I-Grebot/holoboard/elec/bom/holoboard.xlsx

Sheet: Part List Report
 | Component list |  |  | <Parameter Title not found>
 | Source Data From: |  |  | holoboard.PrjPCB
 | Project: |  |  | holoboard.PrjPCB
 | Variant: |  |  | None
 | Report Date: |  | 06/02/2017 | 20:34:35
 | Print Date: |  | 2017-02-07 | 18:57:03
# | Designator | Footprint | Designator | LibRef | Value | Footprint | Part number | Quantity
1 | C1, C6 | C0603 | C1, C6 | Cap | 18pF | C0603 | 1759056 | 2
2 | C2, C4, C5, C7, C8, C9, C13, C22, C23, C32, C33, C34, C35 | C0603 | C2, C4, C5, C7, C8, C9, C13, C22, C23, C32, C33, C34, C35 | Cap | 10nF | C0603 | 1759102 | 13
3 | C3, C11, C16, C17, C18, C20, C21, C28, C29, C30, C31, C36, C37, C38 | C0603 | C3, C11, C16, C17, C18, C20, C21, C28, C29, C30, C31, C36, C37, C38 | Cap | 100nF | C0603 | 9406140 | 14
4 | C10, C12 | Boitier tantale A | C10, C12 | Cap Pol | 2.2µF | Boitier tantale A | 1457419 | 2
5 | C14 | C0805 | C14 | Cap | 10µF | C0805 | 2320851 | 1
6 | C15 | C0603 | C15 | Cap | 1µF | C0603 | 2320814 | 1
7 | C19 | Boitier tantale A | C19 | Cap Pol | 1.5µF | Boitier tantale A | 2408591 | 1
8 | C24, C25, C26, C27 | Boitier tantale B | C24, C25, C26, C27 | Cap Pol | 22µF | Boitier tantale B | 1135057 | 4
9 | C39, C51, C52 | Boitier tantale B | C39, C51, C52 | Cap | 22µF | Boitier tantale B | 2353055 | 3
10 | C40, C41, C42, C43, C44, C45 | Boitier tantale B | C40, C41, C42, C43, C44, C45 | Cap Pol | 10µF | Boitier tantale B | 1457437 | 6
11 | C46, C53, C54 | Boitier tantale C | C46, C53, C54 | Cap Pol | 100µF | Boitier tantale D | 1135058 | 3
12 | C47, C48, C49, C50, C55, C56 | C0805 | C47, C48, C49, C50, C55, C56 | Cap | 2,2µF | C0805 | 2320829 | 6
13 | D1 | WL-SFTW SMD | D1 | CLV1A-FKB |  | WL-SFTW SMD | 1855553 | 1
14 | D2, D3, D4, D5, D6, D7 | KP-2012 | D2, D3, D4, D5, D6, D7 | LED1 |  | KP-2012 |  | 6
15 | L1 | 0805 | L1 | Inductor | 600 @ 100MHz | 0805 |  | 1
16 | P1 | HDR1X6 | P1 | Header 6 |  | HDR1X6 |  | 1
17 | P2, P4 | 22-03-5035 | P2, P4 | Header 3 |  | 22-03-5035 |  | 2
18 | P3 | minitek127-6way | P3 | Header 6 |  | minitek127-6way |  | 1
19 | P5, P8 | 22-03-5045 | P5, P8 | Header 4 |  | 22-03-5045 |  | 2
20 | P6, P7 | 53253-0370 | P6, P7 | Header 3 |  | 53253-0370 |  | 2
21 | P9, P10, P11, P12 | 114-15030 | P9, P10, P11, P12 | Header 4X2 |  | 114-15030 |  | 4
22 | P13, P14, P15, P16, P17, P19, P20, P21, P22, P23, P24, P25, P26, P27, P28, P29, P30, P31 | 7-215079-4 | P13, P14, P15, P16, P17, P19, P20, P21, P22, P23, P24, P25, P26, P27, P28, P29, P30, P31 | Header 4 |  | 7-215079-4 |  | 18
23 | P18 | HDR2X8 | P18 | Header 2X8 |  | HDR2X8 |  | 1
24 | P32, P33, P34, P35, P36, P37, P38, P39 | HDR1X3 | P32, P33, P34, P35, P36, P37, P38, P39 | Header 3 |  | HDR1X3 |  | 8
25 | P40 | HDR1X4 | P40 | Header 4 |  | HDR1X4 |  | 1
26 | P41 | IMO - 20.155MH/4 | P41 | Header 4 |  | IMO - 20.155MH/4 |  | 1
27 | P42 | IMO - 20.155MH/2 | P42 | Header 2 |  | IMO - 20.155MH/2 |  | 1
28 | Q1, Q2, Q3 | SOT-23 | Q1, Q2, Q3 | NMOS-2 |  | SOT-23 |  | 3
29 | R1, R51, R53, R54 | 0603 | R1, R51, R53, R54 | Res2 | 47K | 0603 |  | 4
30 | R2, R3 | 0402 | R2, R3 | Res2 | 0 | 0402 |  | 2
31 | R4 | 0402 | R4 | Res2 | 620 | 0402 |  | 1
32 | R5, R6 | 0402 | R5, R6 | Res2 | 220 | 0402 |  | 2
33 | R7, R8, R9, R10, R35 | 0603 | R7, R8, R9, R10, R35 | Res2 | 10K | 0603 |  | 5
34 | R11, R12, R13, R14 | 2510 | R11, R12, R13, R14 | Res2 | 0.15 | 2510 |  | 4
35 | R15, R16, R17, R18, R19, R25, R26, R27, R28, R29, R48 | 0603 | R15, R16, R17, R18, R19, R25, R26, R27, R28, R29, R48 | Res2 | 1K | 0603 |  | 11
36 | R20, R21, R22, R23, R24, R30, R31, R32, R33, R34 | 0603 | R20, R21, R22, R23, R24, R30, R31, R32, R33, R34 | Res2 | 330 | 0603 |  | 10
37 | R36, R37, R38, R39, R41, R42, R43, R44 | 0603 | R36, R37, R38, R39, R41, R42, R43, R44 | Res2 | 820 | 0603 |  | 8
38 | R40 | 0603 | R40 | Res2 | 120 | 0603 |  | 1
39 | R45 | 0603 | R45 | Res2 | 2K2 | 0603 |  | 1
40 | R46 | 0603 | R46 | Res2 | 680 | 0603 |  | 1
41 | R47 | 0603 | R47 | Res2 | 270 | 0603 |  | 1
42 | R49 | 0603 | R49 | Res2 | 500 | 0603 |  | 1
43 | R50 | 0603 | R50 | Res2 | 1K5 | 0603 |  | 1
44 | R52 | 0603 | R52 | Res2 | 7.5K | 0603 |  | 1
45 | R55 | 0603 | R55 | Res2 | 21K | 0603 |  | 1
46 | R56 | 0603 | R56 | Res2 | 4K02 | 0603 |  | 1
47 | U1 | SOT-23 | U1 | REF3030 |  | SOT-23 |  | 1
48 | U2 | LQFP100 | U2 | STM32F746 |  | LQFP100 |  | 1
49 | U3 | holoboard_mezzanine | U3 | holoboard_mezzanine |  | holoboard_mezzanine |  | 1
50 | U4 | QFN32 | U4 | LCMXO2-256HC |  | QFN32 |  | 1
51 | U5 | SOIC150-8 | U5 | SN75176BDR |  | SOIC150-8 |  | 1
52 | U6, U7, U8, U9 | DDA | U6, U7, U8, U9 | DRV8872 |  | DDA |  | 4
53 | U10, U11, U12, U13 | SOT457 | U10, U11, U12, U13 | 74LVC2G17 |  | SOT457 |  | 4
54 | U14, U15, U16, U17, U18, U19, U20, U21, U22, U23 |  | U14, U15, U16, U17, U18, U19, U20, U21, U22, U23 | EL3H4 |  |  |  | 10
55 | U24 | SOIC150-8 | U24 | MCP2551 |  | SOIC150-8 |  | 1
56 | U25, U26 | SO16 | U25, U26 | ACSL-6400 |  | SO16 |  | 2
57 | U27, U31, U32 | EUW | U27, U31, U32 | PTN78060W |  | EUW |  | 3
58 | U28 | TSR-1 | U28 | TSR_1-2450 |  | TSR-1 |  | 1
59 | U29 | TSR-1 | U29 | TSR_1-24120 |  | TSR-1 |  | 1
60 | U30 | TSR-1 | U30 | TSR 1-2433 |  | TSR-1 |  | 1
61 | Y1 | QC3CA | Y1 | XTAL_4pins |  | QC3CA |  | 1
Approved |  |  |  | Notes |  |  |  | 198

Sheet: Project Information
Project Full Path | F:\Robotique\IGrebot\Github\holoboard\elec\src\holoboard.PrjPCB
Project Filename | holoboard.PrjPCB
Variant Name | None
Data-Source Filename | holoboard.PrjPCB
Data-Source Full Path | F:\Robotique\IGrebot\Github\holoboard\elec\src\holoboard.PrjPCB
Title | <Parameter Title not found>
Total Quantity | 198
Report Time | 20:34:35
Report Date | 06/02/2017
Report Date & Tine | 06/02/2017 20:34:35
Output Name | Bill of Materials
Output Type | BOM_PartType
Output Generator Name | BOM
Output Generator Description | Bill of Materials
