I-Grebot/holoboard/elec/pdf/holoboard_schematics.pdf

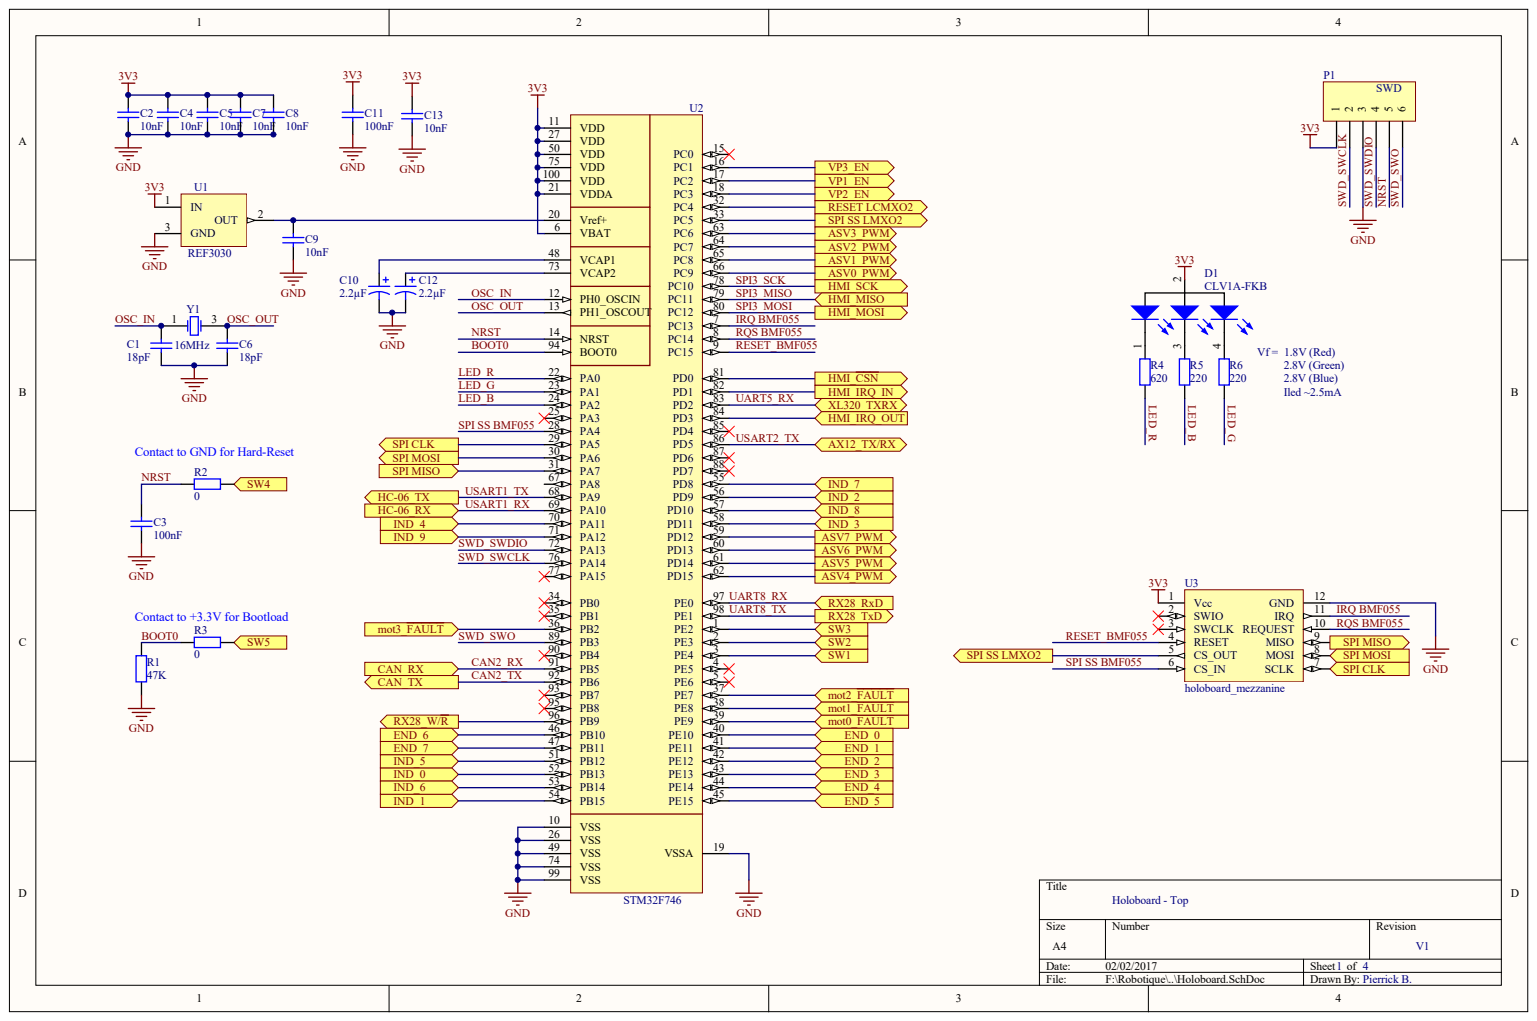
[picture p1: page 1]

2 6
4 9
7 4
9 9

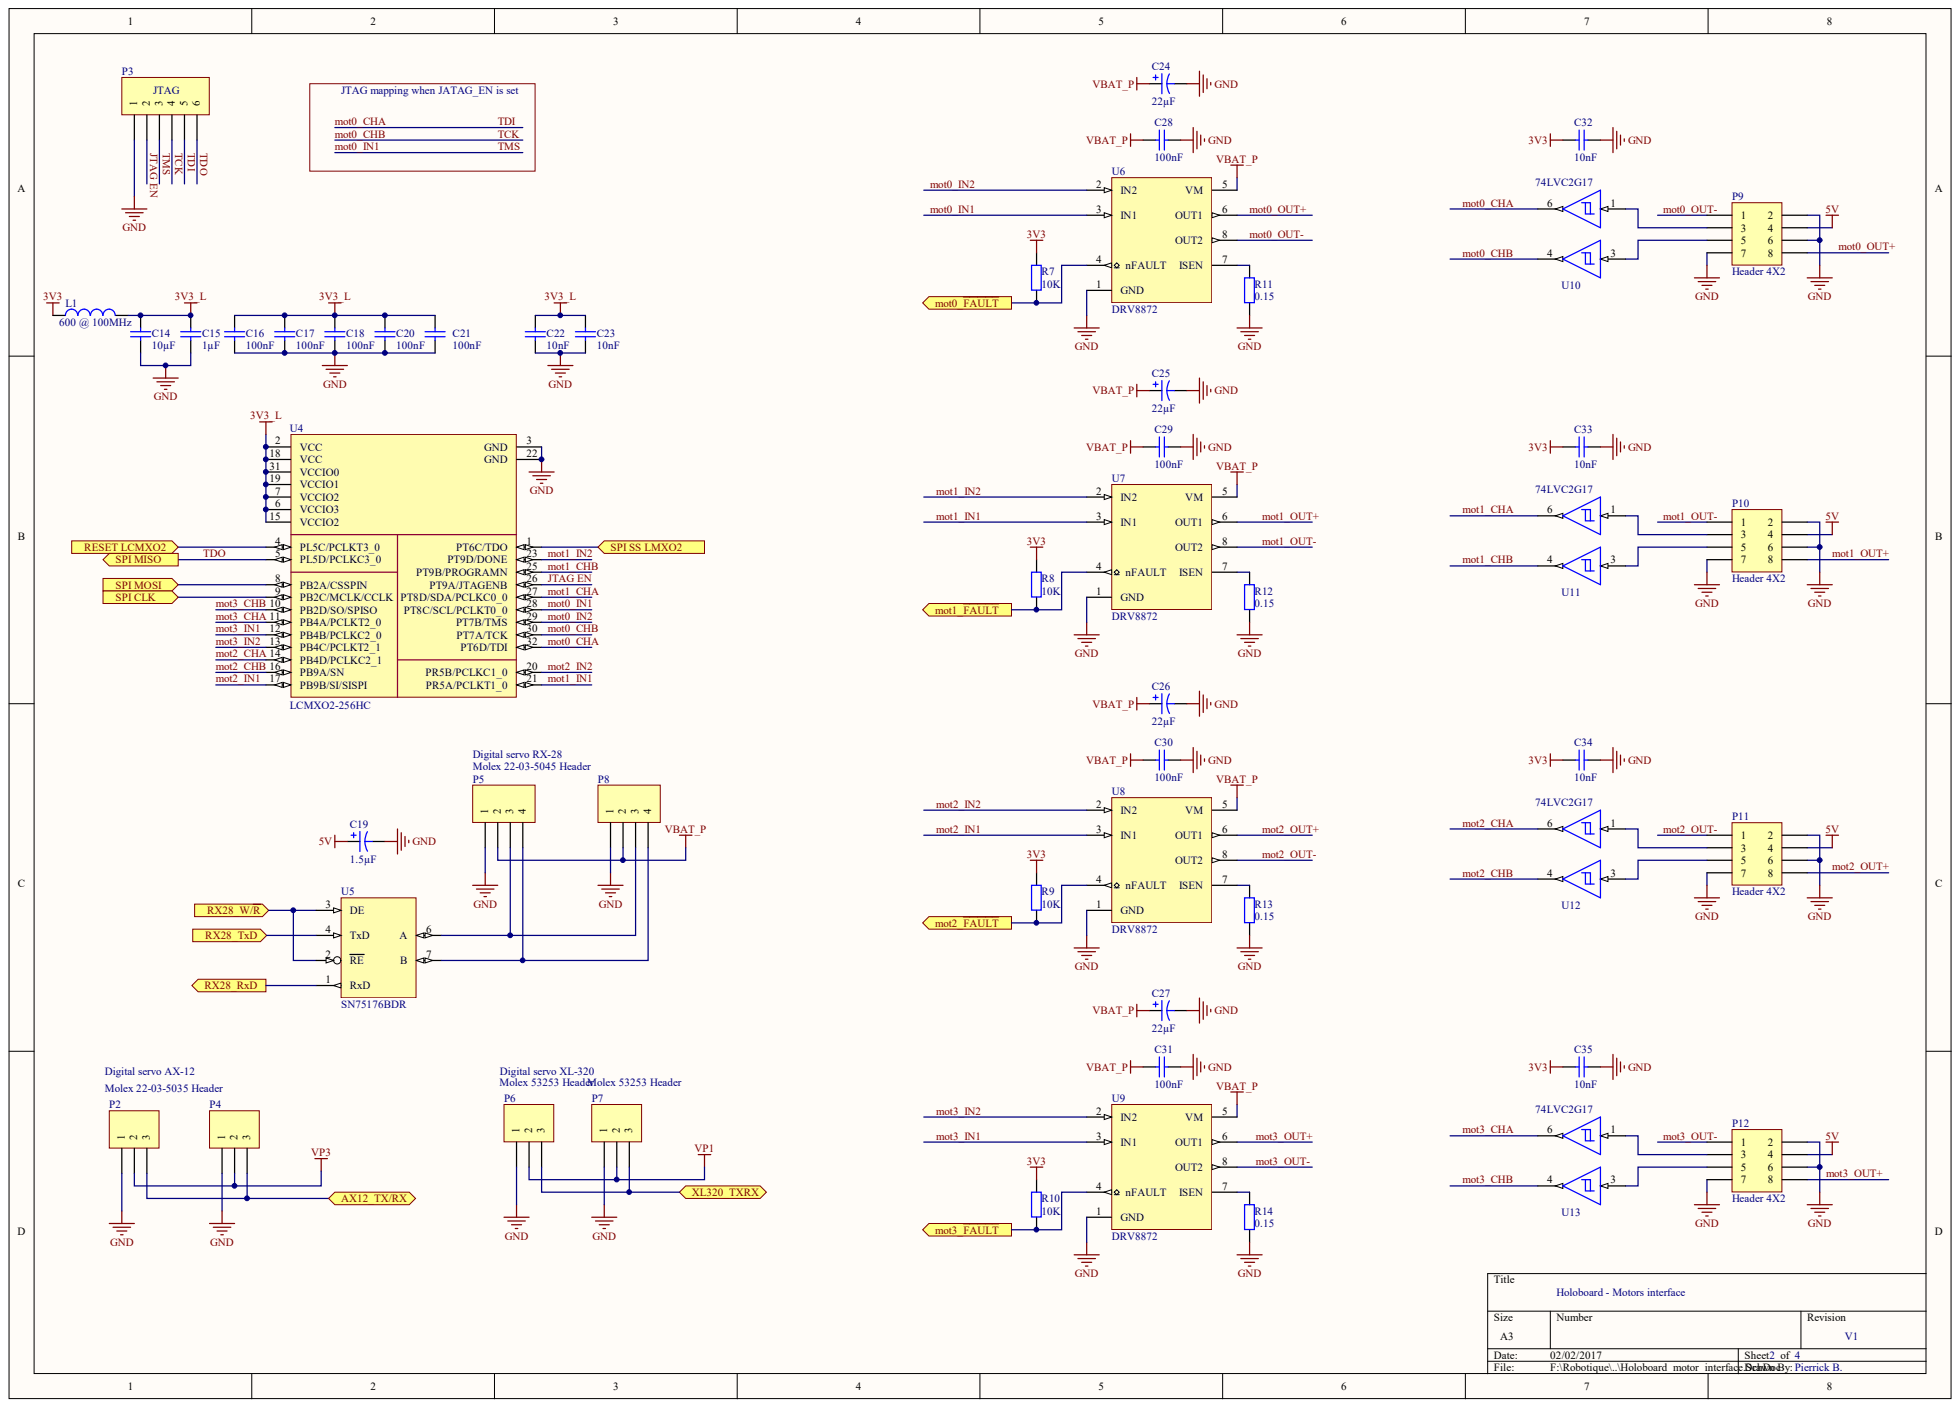
[picture p2: page 2]

JTAG mapping when JATAG_EN is set

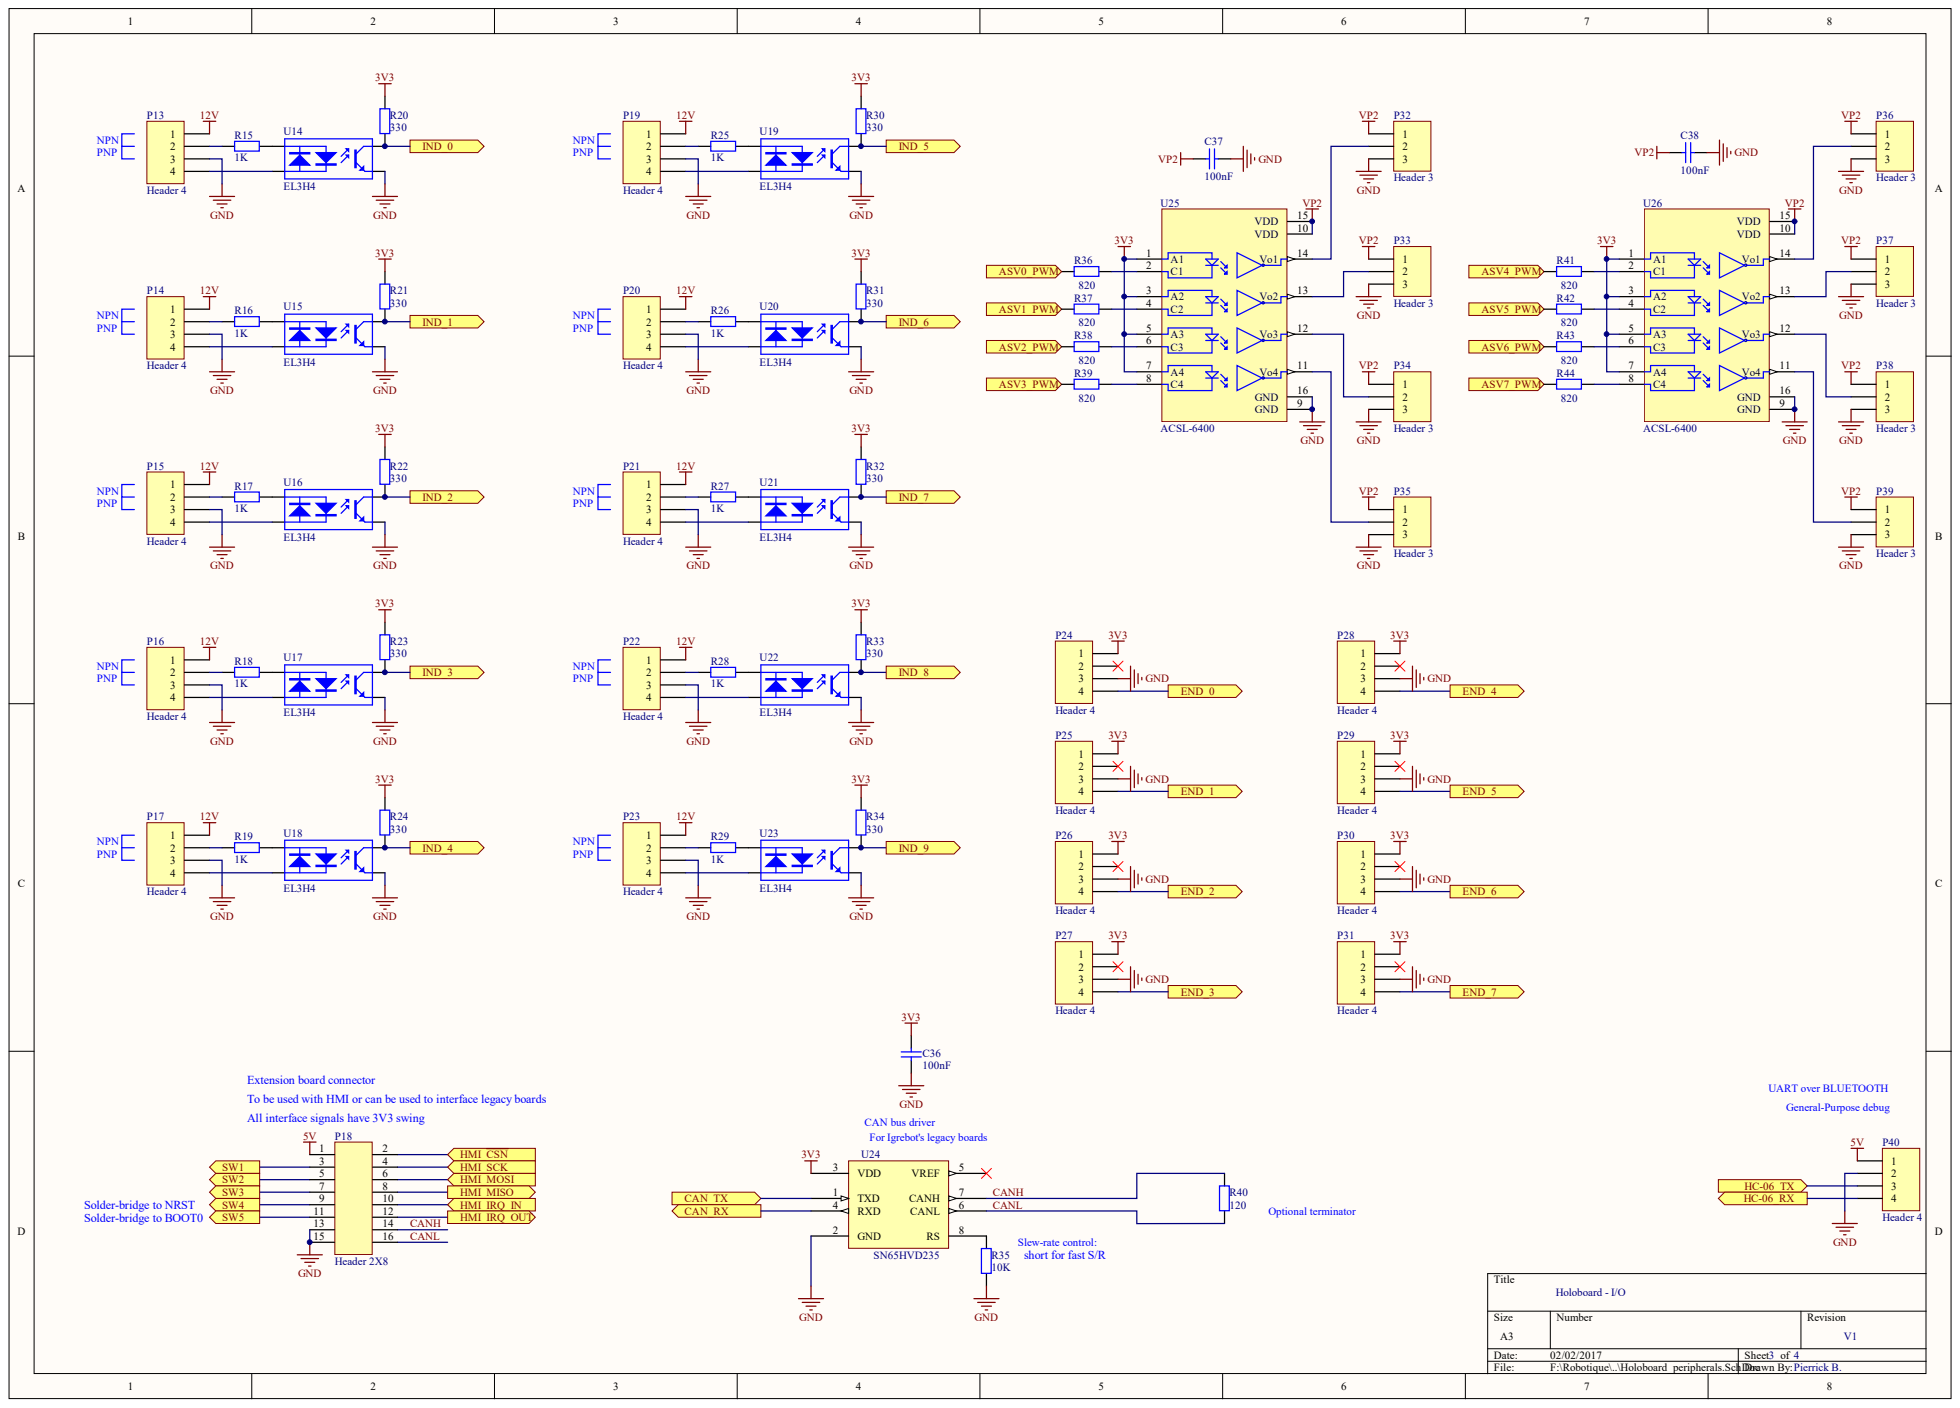
[picture p3: page 3]

Extension board connector
To be used with HMI or can be used to interface legacy boards
All interface signals have 3V3 swing

CAN bus driver
For Igrebot's legacy boards
VDD 3

Solder-bridge to NRST
Solder-bridge to BOOT0

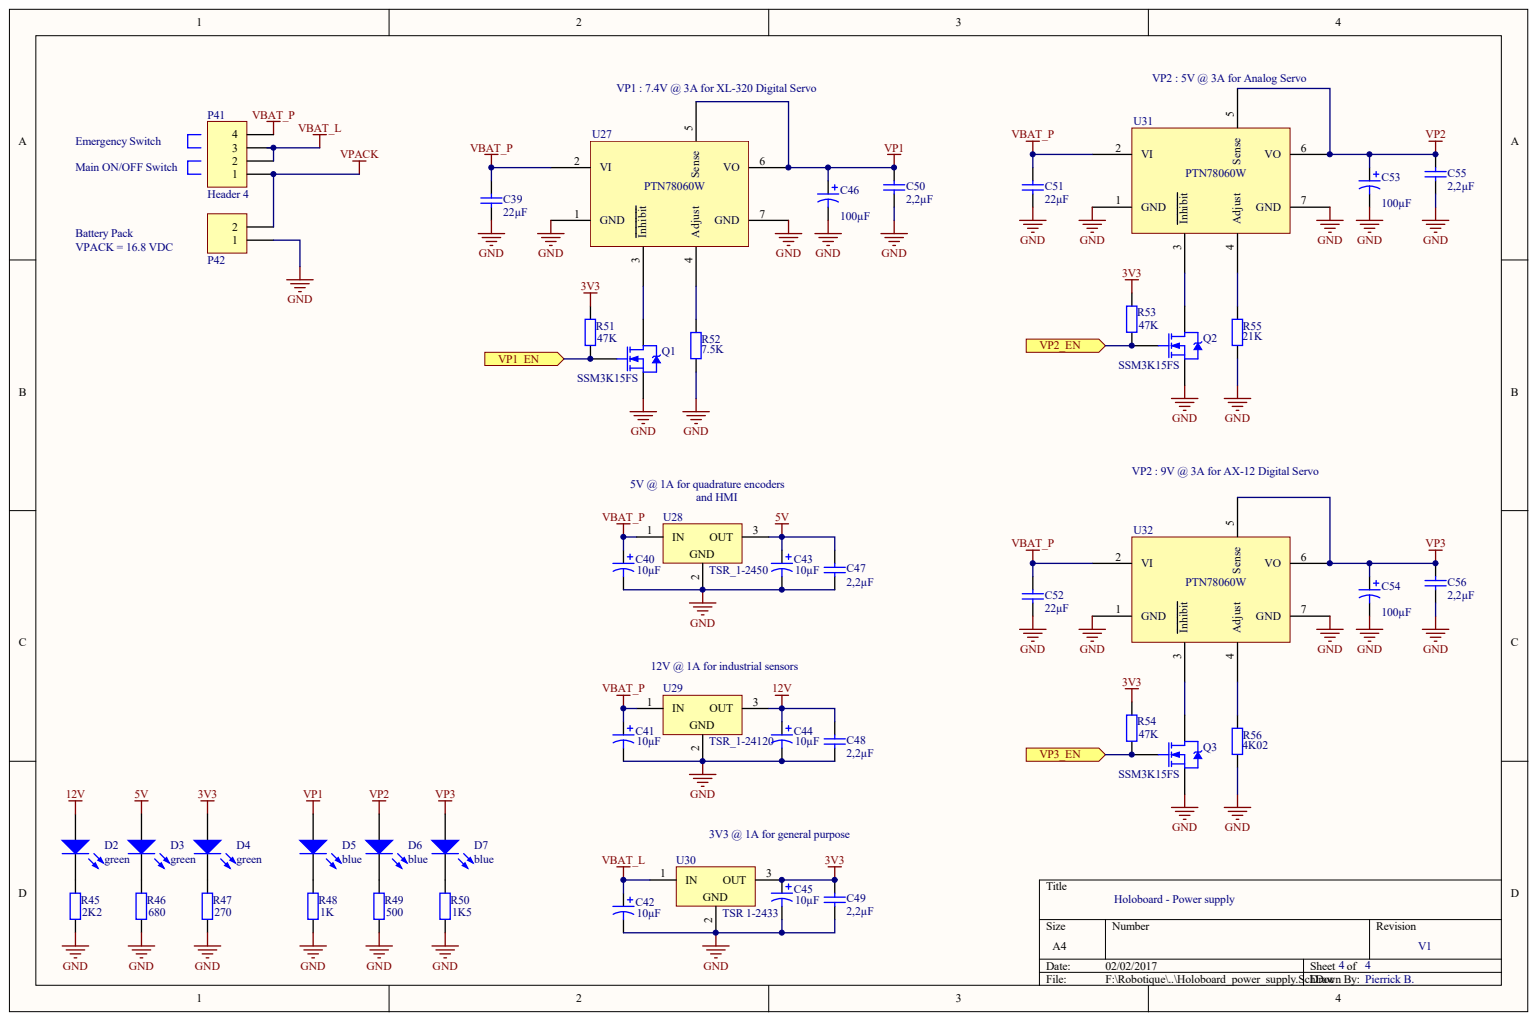
[picture p4: page 4]
