I-Grebot/holoboard/elec/pdf/holoboard_mezzanine.pdf

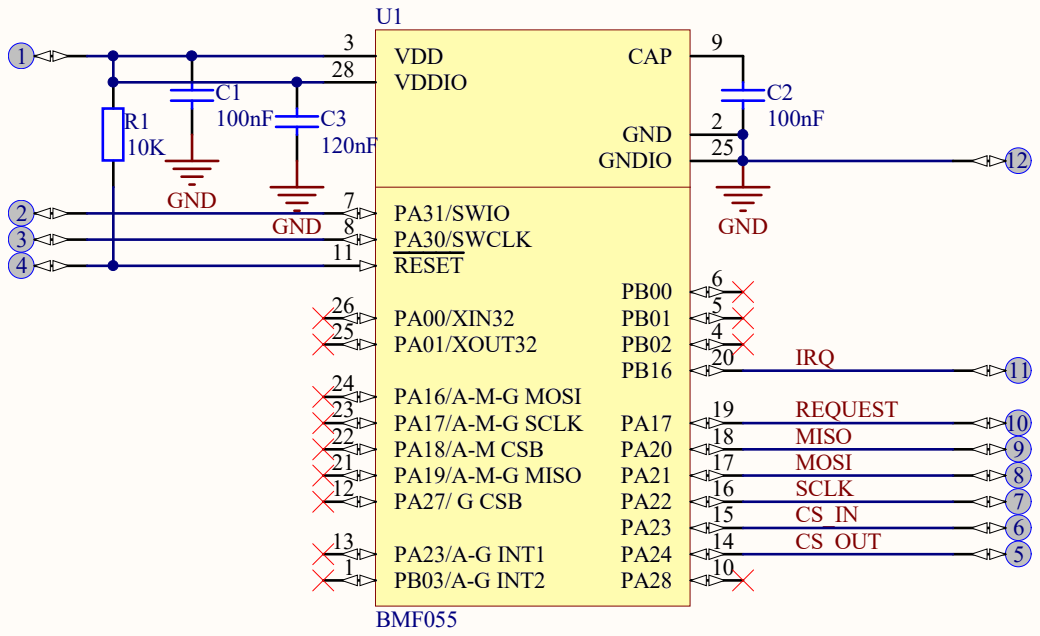
[picture p5: page 1]
