I-Grebot/holoboard/(list of files, drawings)

Other design files:
elec/src/holoboard.PcbDoc
elec/src/holoboard.PrjPCB
elec/src/Holoboard.SchDoc
elec/src/holoboard_mezzanine.PcbDoc
elec/src/holoboard_mezzanine.PrjPCB
elec/src/Holoboard_mezzanine.SchDoc
elec/src/Holoboard_motor_interface.SchDoc
elec/src/Holoboard_peripherals.SchDoc
elec/src/Holoboard_power_supply.SchDoc
