I-Grebot/holoboard/firm/src/Projects/2017_T1_R2/include/hardware_const.h

/* -----------------------------------------------------------------------------
 * HoloBoard
 * I-Grebot 2017
 * -----------------------------------------------------------------------------
 * @file       hardware_const.h
 * @author     Pierrick
 * @date       Apr 23, 2017
 * @version    V1.0
 * -----------------------------------------------------------------------------
 * @brief
 *   This file contains some hardware constant definitions
 * -----------------------------------------------------------------------------
 * Versionning informations
 * Repository: https://github.com/I-Grebot/holoboard.git
 * -----------------------------------------------------------------------------
 */

#ifndef __HARDWARE_CONST_H
#define __HARDWARE_CONST_H



/**
********************************************************************************
**
**  LED
**
********************************************************************************
*/

/* LED PWM Period and Brightness value (global), ticks unit*/
#define LED_PWM_PERIOD_TICK      20
#define LED_PWM_DUTY_TICK        1

/* Slow blinking periods (ticks x PWM_PERIOD unit) */
#define LED_BLINK_SLOW          100
#define LED_BLINK_FAST           10

/**
********************************************************************************
**
**  Serial Interface
**
********************************************************************************
*/

#define SERIAL_BAUDRATE         115200

#define SERIAL_ISR              DBG_ISR
#define SERIAL_COM              DBG_COM

#define SERIAL_RX_QUEUE_LEN     64
#define SERIAL_TX_QUEUE_LEN    256 // That's only because we like to transmit

#define SERIAL_RX_TIMEOUT      pdMS_TO_TICKS( 10 )
#define SERIAL_TX_TIMEOUT      pdMS_TO_TICKS( 10 )

#endif /* __HARDWARE_CONST_H */
