I-Grebot/holoboard/firm/src/Projects/2017_T1_R2/include/ir_sensors.h

/*
 * ir_sensors.h
 *
 *  Created on: May 25, 2017
 *      Author: ldoppea
 */

#ifndef PROJECTS_2017_T1_R2_INCLUDE_IR_SENSORS_H_
#define PROJECTS_2017_T1_R2_INCLUDE_IR_SENSORS_H_

//faces sensors
extern uint8_t sensor0detect, sensor1detect, sensor2detect;

//angle sensors
extern uint8_t sensor3detect, sensor4detect, sensor5detect;

#endif /* PROJECTS_2017_T1_R2_INCLUDE_IR_SENSORS_H_ */
