I-Grebot/holoboard/(commit log)

2017-01-04 Use simple spi instead of EFB spi
    modify code to fit into LCMXO2-2256HC
    Need to be cleaned but is commented
2017-01-15 Add elec sources
    [Holoboard.SchDoc, Holoboard_mezzanine.SchDoc, Holoboard_motor_interface.SchDoc, Holoboard_peripherals.SchDoc, Holoboard_power_supply.SchDoc, holoboard.PcbDoc, holoboard.PrjPCB, holoboard_mezzanine.PcbDoc]
2017-01-15 Rebuilt projects and Add pdf
    [Holoboard_motor_interface.SchDoc, Holoboard_peripherals.SchDoc, Holoboard_power_supply.SchDoc, holoboard.PrjPCB]
2017-02-02 Update schematic after review and routing
    [Holoboard.SchDoc, Holoboard_motor_interface.SchDoc, Holoboard_peripherals.SchDoc, Holoboard_power_supply.SchDoc, holoboard.PrjPCB, holoboard_mezzanine.PrjPCB]
2017-03-02 Small mistake correction before seeedstudio
    Correction + gerber generation
    [Holoboard.SchDoc, Holoboard_motor_interface.SchDoc, Holoboard_power_supply.SchDoc, holoboard.PrjPCB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]
2017-04-23 Unit test commit
    Forcing motor output to test driver.
2017-04-23 Add STM32 projet
    Simple projet that blink the led in blue with FREERTOS
2017-05-20 First robot control
    Add matric, add PID
2017-05-23 Implemented calibration calculus (ratio distance/ticks) and moved motion logic into a dedicated function
2017-05-25 Added IR Sensors reading
2017-05-25 Added tirette reading
2017-05-25 displacement OK, sensor to validate on table
2017-05-25 Not tested : added IR sensors on each corners
2017-05-25 Added delay before first move, changed tirette pin, changed trajectory
2017-05-25 added power management functions, not yet used in robot strategy
2017-05-26 Added color switch, recalage, power
